OSdrone/TM4Cdrone/README.txt

The documentation is in Spanish, it wil be translated soon. On other hand, there is a lot of 
information in English.

The project is being migrated to Q15 from float.
 
It is under development, but the main features work it.

////////////////////////////////////////////////////////////////////////////////////////////
Memoria del proyecto en castellano.

Actualmente en coma flotante ("float"), se esta portando a Q15.

En desarrollo pero funcional.
