OSdrone/TM4Cdrone/PCB/GERBER/README.txt

NOT FINAL VERSION, IT CONTAINS MISTAKES

MISTAKES

bad footprint of 3.3V Regulators
BJT are mirrored

Fallos

Reguladores de tension a 3.3V, El pad grande es VOUT no GND
Los bjt tienen pines incorrectos, estan al reves
(Correguido) Cortocircuito entre el clock de 32K y la resistencia de reser
