OSdrone/TM4Cdrone/PCB/Controladora_Final.pdf

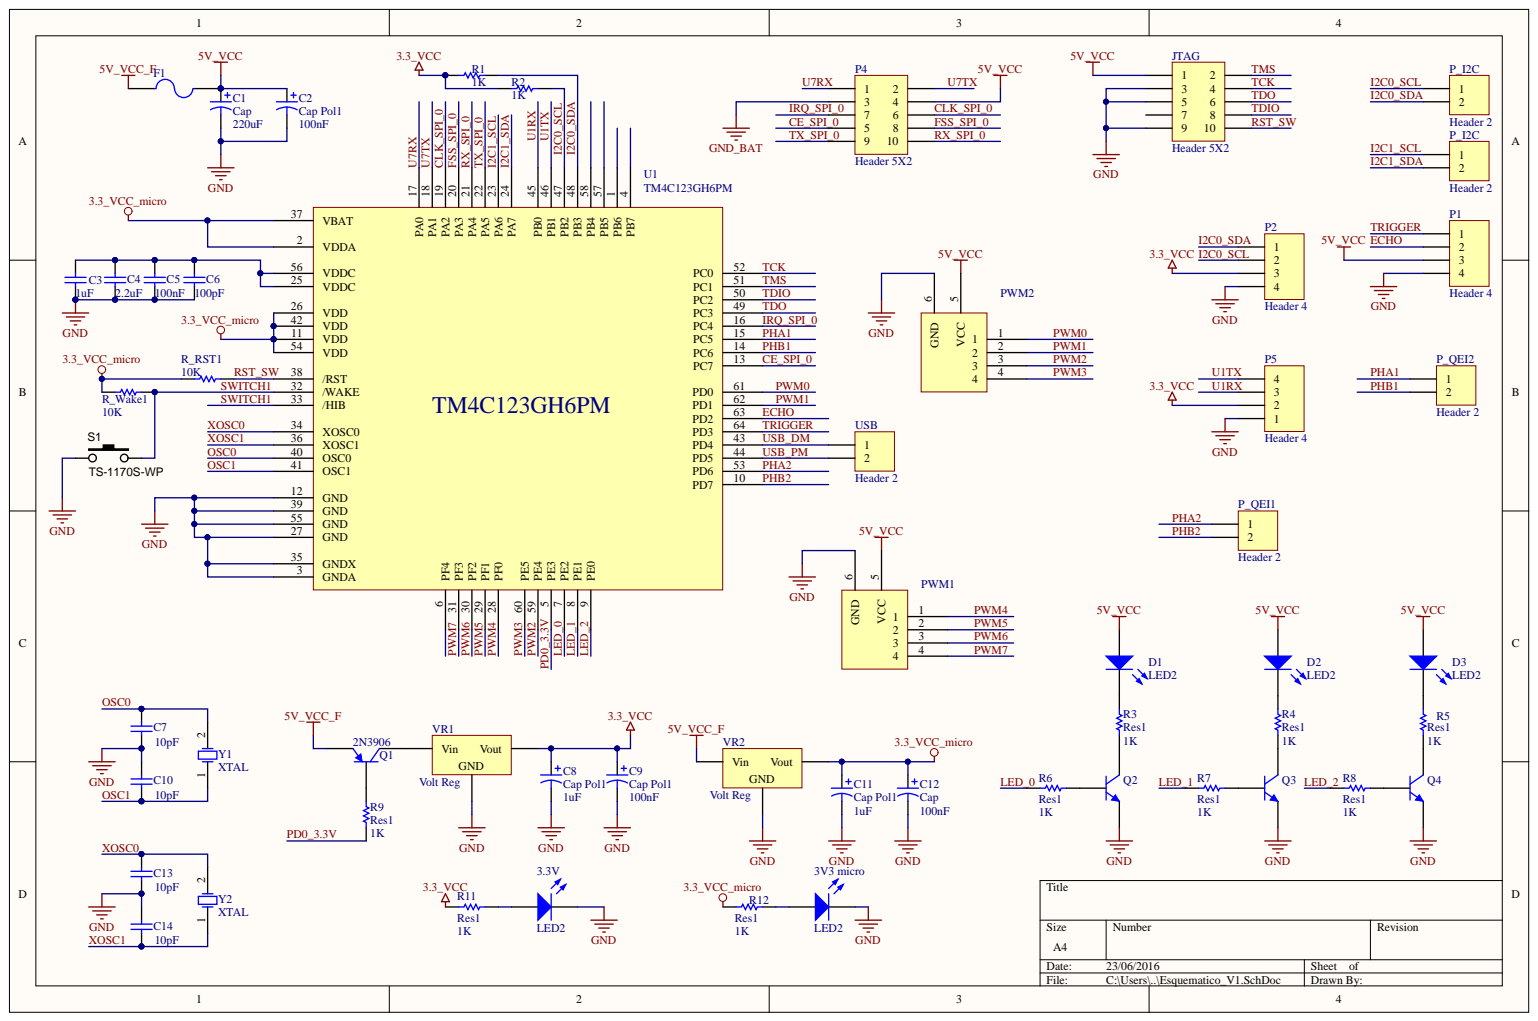
[picture p24: page 1]

GND 39

GND 27

GNDA 3

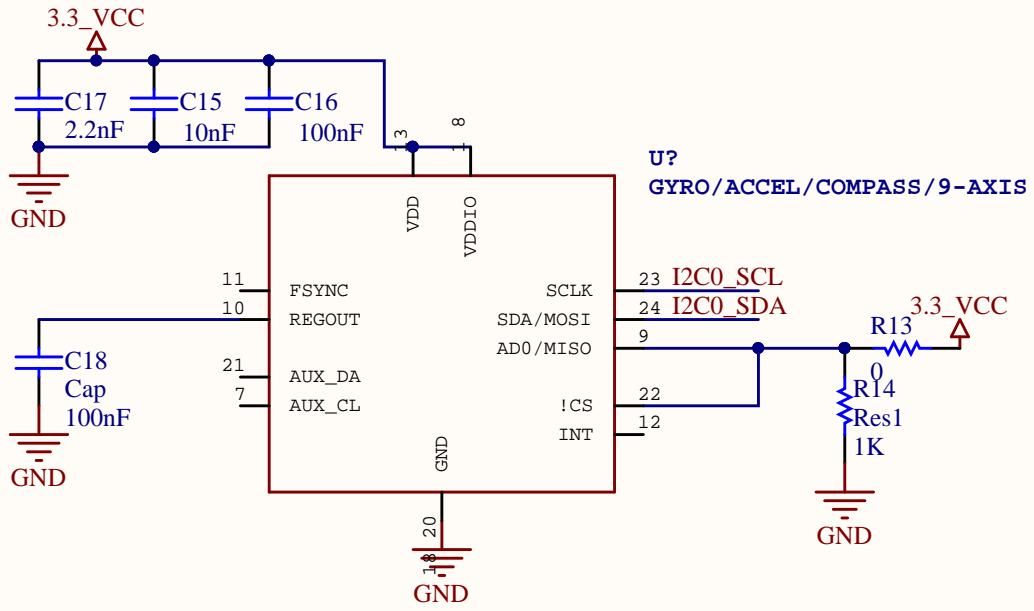
[picture p25: page 2]

GYRO/ACCEL/COMPASS/9-AXIS

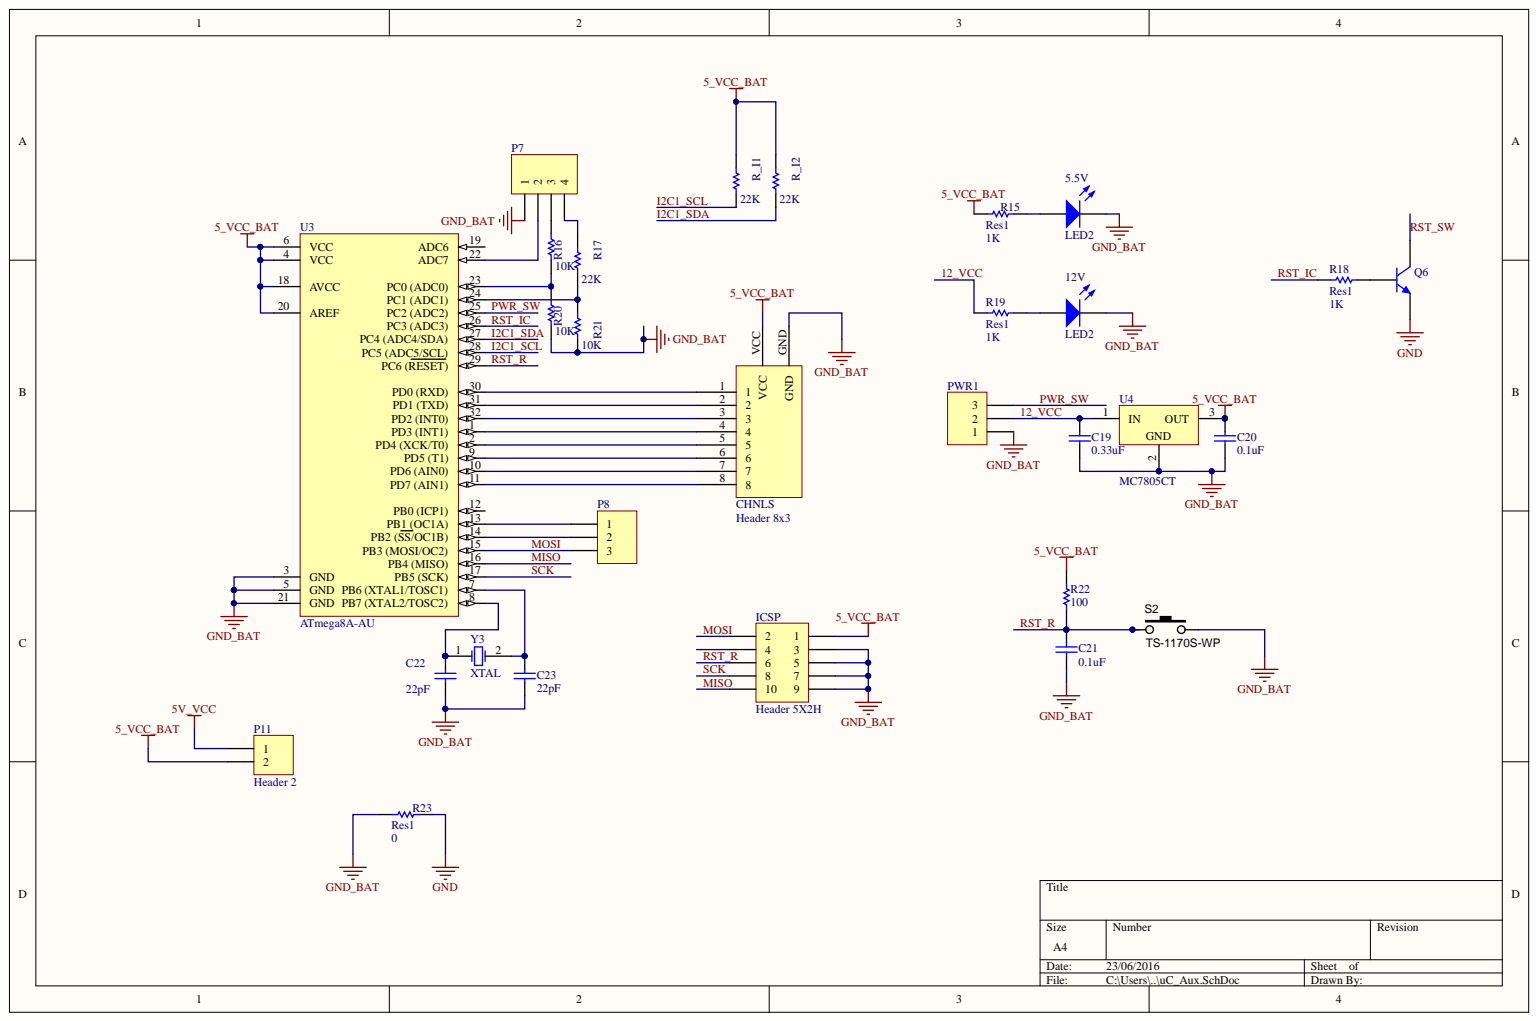
[picture p26: page 3]
